grasmanek94/wtw-sensor-system/Case/Anemometer/pictures/IMG_20230727_215032.jpg

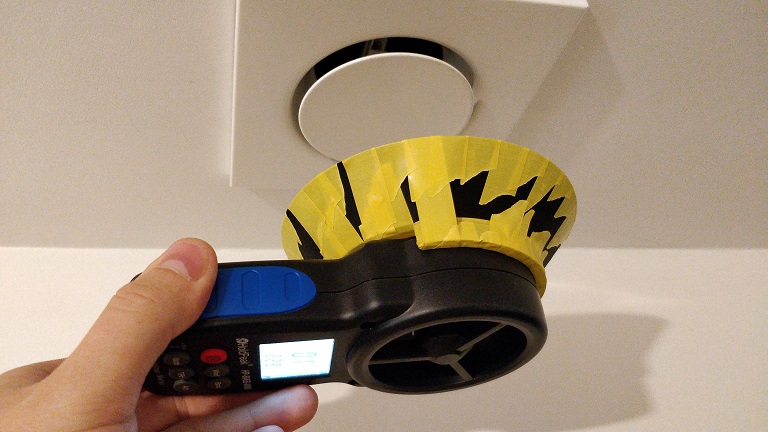
Case/Anemometer/pictures/IMG_20230727_215032.jpg
