grasmanek94/wtw-sensor-system/Case/Anemometer/pictures/IMG_20230727_215119.jpg

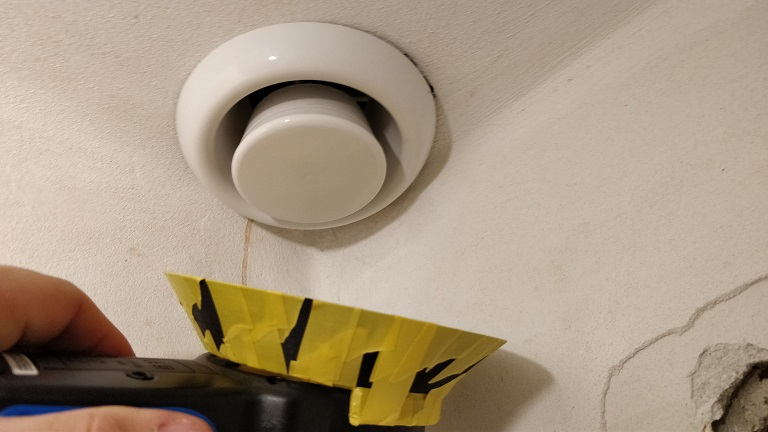
Case/Anemometer/pictures/IMG_20230727_215119.jpg
