grasmanek94/wtw-sensor-system/Case/Anemometer/pictures/IMG_20230727_215125.jpg

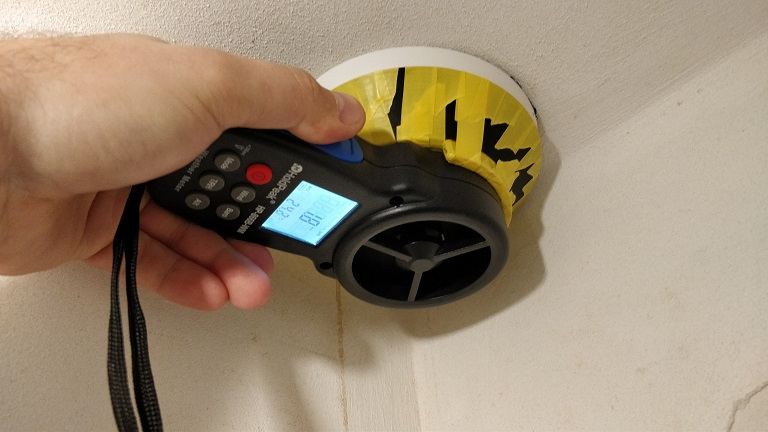
Case/Anemometer/pictures/IMG_20230727_215125.jpg
