grasmanek94/wtw-sensor-system/Case/BOM.png

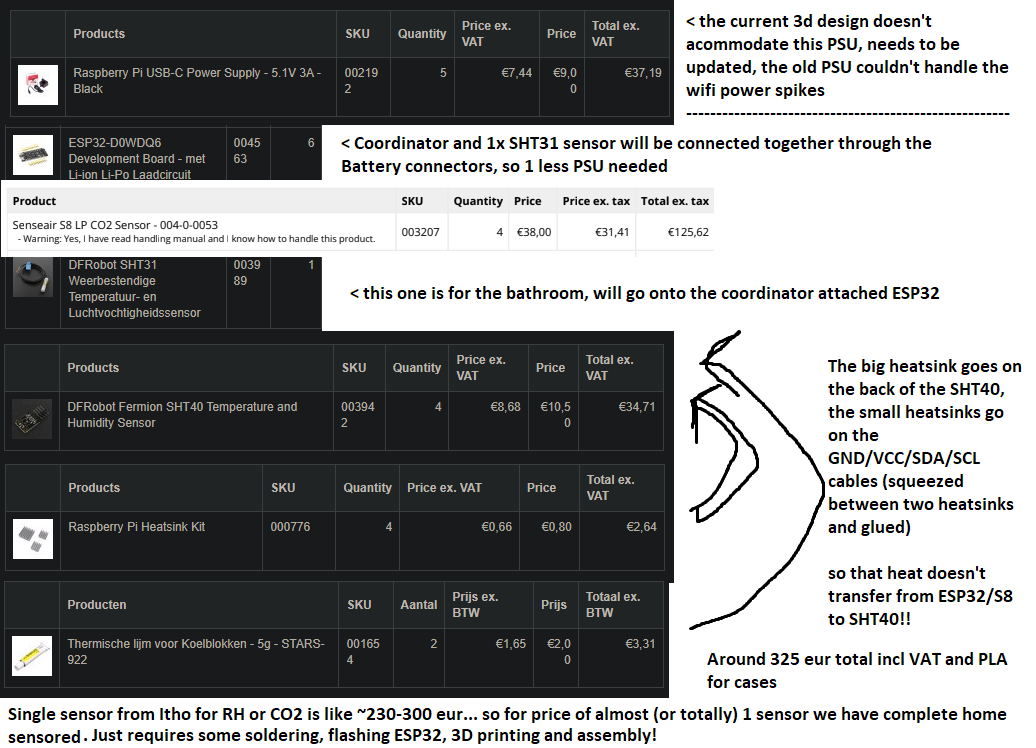
Case/BOM.png
