grasmanek94/wtw-sensor-system/Case/Anemometer/AVS.FCStd

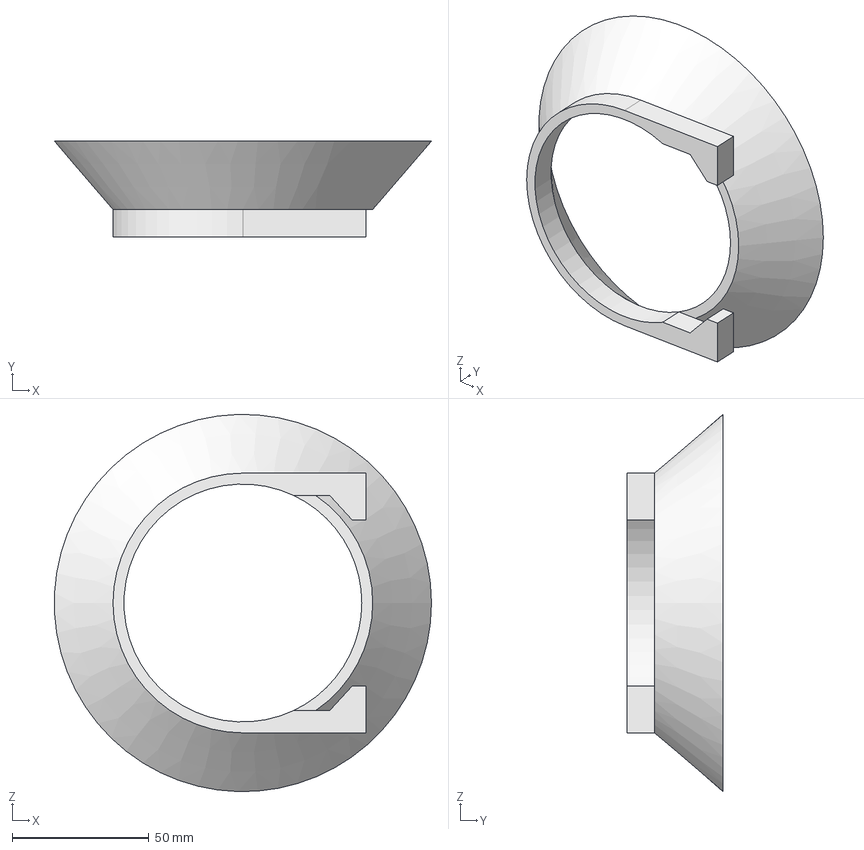
[picture p9: CAD file, 2023-07-27]
Case/Anemometer/AVS.FCStd
137.9 x 35.0 x 138.0 mm
