grasmanek94/wtw-sensor-system/Case/Co2Sensor-CasingBaseFilet.stl

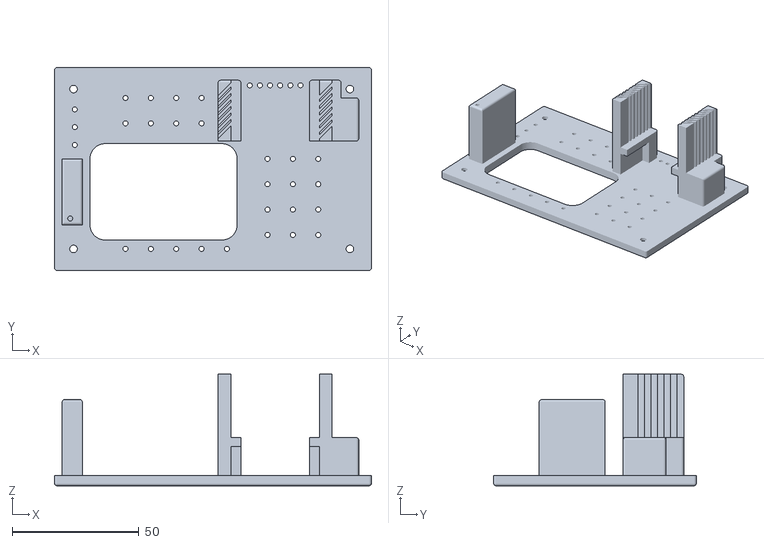
[picture p10: CAD file, 2023-07-16]
Case/Co2Sensor-CasingBaseFilet.stl
125.0 x 80.0 x 44.0
