grasmanek94/wtw-sensor-system/Case/Co2Sensor-CasingWallFilet.stl

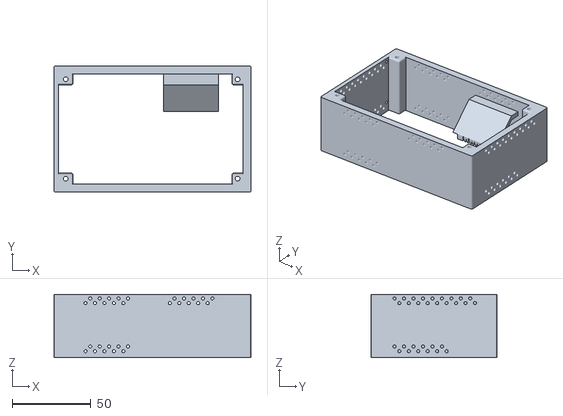
[picture p11: CAD file, 2023-07-16]
Case/Co2Sensor-CasingWallFilet.stl
125.0 x 80.0 x 40.0
