grasmanek94/wtw-sensor-system/Case/Co2Sensor-CasingCoverFilet.stl

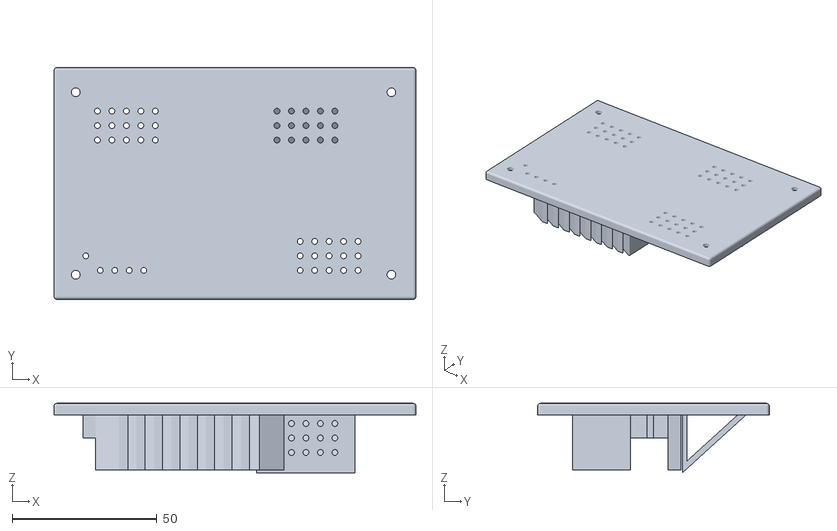
[picture p12: CAD file, 2023-07-16]
Case/Co2Sensor-CasingCoverFilet.stl
125.0 x 80.0 x 24.0
