grasmanek94/wtw-sensor-system/(list of files, cad)

Other CAD files:
Case/Anemometer/AVS-Cone.stl
Case/Co2Sensor.FCStd
