grasmanek94/wtw-sensor-system/Sensor_POE_S3/src/Sensor_MZH19.hpp

#pragma once

#include "Sensor_Interface.hpp"
#include "SensorHasTempOffset.hpp"

#include <HardwareSerial.h>
#include <MHZ19.h>

#ifndef SENSOR_INTERFACE_MHZ19_INCLUDED
#define SENSOR_INTERFACE_MHZ19_INCLUDED 1
#endif

class Sensor_MHZ19: public Sensor_Interface, public SensorHasTempOffset {
private:
	HardwareSerial ss;
	MHZ19 mhz;

	bool auto_calibration;
	float last_measured_temp;
	int last_measured_co2_ppm;
	unsigned long last_measurement_time;
	bool new_measurement_available;
	SENSOR_LOCATION location;

	const unsigned long meassurement_elapsed_millis = 4000;

public:
	Sensor_MHZ19(bool auto_calibration = false, uint8_t hardware_serial_nr = 2, 
		SENSOR_LOCATION location = (SENSOR_LOCATION)0,
		float temp_offset_x = 1.0f, float temp_offset_y = 0.0f);

	virtual ~Sensor_MHZ19();

	virtual void setup() override;
	virtual void print_measurement() const override;
	virtual void update() override;
	virtual bool has_new_data() override;
	virtual bool has_temperature() const override;
	virtual bool has_co2_ppm() const override;
	virtual float get_temperature() override;
	virtual int get_co2_ppm() override;

	virtual const char* const get_name() const override;
	virtual SENSOR_LOCATION get_location() const override;
};
