grasmanek94/wtw-sensor-system/Sensor_POE_S3/src/Sensor_SHT4X.hpp

#pragma once

#include "Sensor_Interface.hpp"
#include "SensorHasTempOffset.hpp"

#include <Adafruit_SHT4x.h>

#ifndef SENSOR_INTERFACE_SHT4X_INCLUDED
#define SENSOR_INTERFACE_SHT4X_INCLUDED 1
#endif

class Sensor_SHT4X : public Sensor_Interface, public SensorHasTempOffset {
private:
	int i2c_sda_pin;
	int i2c_scl_pin;
	int wire;
	Adafruit_SHT4x sht4;
	sht4x_precision_t precision;
	float last_measured_rh_value;
	float last_measured_temp;
	bool new_measurement_available;
	bool found;
	SENSOR_LOCATION location;
	TwoWire* i2c_intf;

public:
	Sensor_SHT4X(int i2c_sda_pin = 15, int i2c_scl_pin = 4, 
		sht4x_precision_t precision = SHT4X_HIGH_PRECISION, SENSOR_LOCATION location = (SENSOR_LOCATION)0, 
		float temp_offset_x = 1.0f, float temp_offset_y = 0.0f,
		int wire = 1);

	virtual ~Sensor_SHT4X();

	virtual void setup() override;
	virtual void print_measurement() const override;
	virtual void update() override;
	virtual bool has_new_data() override;
	virtual bool has_temperature() const override;
	virtual bool has_relative_humidity() const override;
	virtual bool is_present() const override;
	virtual float get_temperature() override;
	virtual float get_relative_humidity() override;

	virtual const char* const get_name() const override;
	virtual SENSOR_LOCATION get_location() const override;
};
