grasmanek94/wtw-sensor-system/Sensor_POE_S3/src/Sensor_Interface.hpp

#pragma once

#include "SensorLocation.hpp"

class Sensor_Interface {
public:
	Sensor_Interface() {}
	virtual ~Sensor_Interface() {}

	virtual const char* const get_name() const { return ""; }
	virtual void setup() {}
	virtual void print_measurement() const {}
	virtual void update() {}
	virtual bool has_new_data() { return false; }
	virtual bool has_temperature() const { return false; }
	virtual bool has_relative_humidity() const { return false; }
	virtual bool has_co2_ppm() const { return false; }
	virtual bool has_meter_status() const { return false; }
	virtual bool is_present() const { return true; }
	virtual float get_temperature() { return 0.0f; }
	virtual float get_relative_humidity() { return 0.0f; }
	virtual int get_co2_ppm() { return 0; }
	virtual int get_meter_status() { return 0; }
	virtual SENSOR_LOCATION get_location() const { return (SENSOR_LOCATION)0; }
};
