grasmanek94/wtw-sensor-system/Sensor_POE_S3/src/HTTPPages.hpp

#pragma once
#include <ESPAsyncWebServer.h>

const int HTTP_OK = 200;
const int HTTP_OK_NO_CONTENT = 204;
const int HTTP_BAD_REQUEST = 400;
const int HTTP_FORBIDDEN = 403;
const int HTTP_INSUFFICIENT_STORAGE = 507;

void http_page_not_found(AsyncWebServerRequest* request);
void http_page_flash(AsyncWebServerRequest* request);
void http_api_flash(AsyncWebServerRequest* request);
void http_api_flash_part(AsyncWebServerRequest* request, String filename, size_t index, uint8_t* data, size_t len, bool final);
void http_api_config(AsyncWebServerRequest* request);
void http_page_config(AsyncWebServerRequest* request);
