grasmanek94/wtw-sensor-system/(commit log)

2023-07-02 Fix hostname not being set
    [Coordinator.ino]
2023-07-03 Fix submitting status to HRU350
    [VentilationState.cpp]
2023-07-03 Small fixes and adjustments
    [LittleFS.hpp, Sensor.ino]
2023-07-05 Add support for S8 sensor and add sensor status to data.
2023-07-06 Add first boot calibration mechanism
2023-07-16 Add design for case and BOM
    [Co2Sensor-CasingBaseFilet.stl, Co2Sensor-CasingCoverFilet.stl, Co2Sensor-CasingWallFilet.stl, Co2Sensor.FCStd]
2023-07-19 Refactor sensor code and add OTA update to sensor
2023-07-20 Fix SHT4x sensor, add config page to sensor, add Sensor OTA update, add config page to coordinator
    [Coordinator.ino, HTTPPages.hpp, LittleFS.cpp, LittleFS.hpp, Sensor.ino, Sensor_SHT41.cpp, Sensor_SHT41.hpp]
2023-07-20 Make incluseion / usage of other sensors easier
2023-07-22 add sequence number to detect if device has been reset
    [Coordinator.ino, DeviceData.cpp, DeviceData.hpp, Sensor.ino, Sensor_S8.hpp]
2023-07-26 Allow specifying temperature offset
2023-07-27 Fix HTTP sensor page restarting device too soon
    [Sensor.ino]
2023-07-27 Add anemometer stuff
    [AVS-Cone.stl, AVS.FCStd]
2023-07-27 Prepare for SENSOR_LOCATION data
2023-07-28 Add support for multiple locations in Sensor, and multiple devices in one sensor, todo: Update Coordinator
2023-07-29 Add sensor location to devices viewer
2023-07-29 Open URL on CTRL+Click device ID
2023-07-29 Fix averages staying at 0 for relative time
    [DeviceData.cpp]
2023-07-30 Add time-based data request instead of sequence based (gets reset to 0 when sensor is restarted, but coordinator keeps running so knows the time)
    [Coordinator.ino, VentilationState.cpp]
2023-07-31 Fix small attainable rh state determination bug
    [Coordinator.ino, DeviceData.cpp]
2023-07-31 Adjust attainable for outside sensor
2023-07-31 Finish adding logic for attainable rh and also make offsets configurable per sensor (moved from global to sensor config)
2024-02-29 Prepare for ventilation matrix. Moved project to platformio setup.
    [mode.xlsx]
2024-03-03 move to co2 matrix in full
    [mode.xlsx]
2024-03-12 Fix memory leak with json arrays, fix gps baud setting, optimize json file storage and loading.
    [Coordinator.cpp, HTTPPages.hpp, LittleFS.cpp]
2024-04-02 add in-code default values, add usage of average temperature for co2 matrix for all sensors
2024-04-13 Add co2 matrix state to device measurement info, fix bug when selecting zero matrix state, add release firmware for OTA flashing.
    [DeviceData.cpp, LittleFS.cpp, LittleFS.hpp, MeasurementEntry.cpp, MeasurementEntry.hpp]
2024-04-18 Add updated builds
    [vent.xlsm]
2025-06-21 - Add mutexes to data submission/access - Remove old coordinatorviewer (replaced by HTML/JS/PHP coordinatorviewer) - Limit response chunk size to 2KiB instead of 5 KiB, this _Seems_ to fix the issue 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
    [Coordinator.cpp, DeviceData.cpp, DeviceData.hpp]
2026-06-13 Add WIP/initial support for Waveshare POE ESP32 S3
2026-06-14 Fix poe sensor
2026-06-20 Display current sensor data on config page for sensor, show IPv6 link local address, show local address, enable ipv6
2026-06-20 printf to Serial.printf
2026-06-20 ditch Arduino HTTP Client which can't do IPv6 addresses, use more modern and better esp32 http client
2026-06-20 also print received data from srv
